ZoomingGuy2/RSFQ-test-board/README.md

# Digital RSFQ Test PCB

## Specs
- PCB designedi for I/O speeds up to 200 MHz
- 10 inputs, 20 outputs
- Compatible with CMOD A7-35T FPGA board
- 512KB SRAM
- 4MB Quad-SPI Flash
- 20,800 LUT
- 41,600 FF
- 225 KB BRAM
- 4.3W max power consumption
