ZoomingGuy2/RSFQ-test-board/test_board/production/bom.csv

Designator | Footprint | Quantity | Value | LCSC Part #
R1, R11, R13, R15, R17, R19, R21, R23, R25, R27, R29, R3, R31, R33, R35, R37, R39, R5, R7, R9 | R_0603 | 20 | 1.5kΩ | C22843
R10, R12, R14, R16, R18, R2, R20, R22, R24, R26, R28, R30, R32, R34, R36, R38, R4, R40, R41, R42, R43, R44, R45, R46, R47, R48, R49, R50, R6, R8 | R_0603 | 30 | 51Ω | C23197
RF1, RF10, RF11, RF12, RF13, RF14, RF15, RF16, RF17, RF18, RF19, RF2, RF20, RF21, RF22, RF23, RF24, RF25, RF26, RF27, RF28, RF29, RF3, RF30, RF4, RF5, RF6, RF7, RF8, RF9 | SMA-TH_BWSMA-KE-Z001 | 30 | BWSMA-KE-Z001 | C496549
U1, U10, U11, U12, U3, U5, U6, U7, U8, U9 | SC-70-5_L2.0-W1.3-P0.65-LS2.1-BR | 10 | TLV3601DCKR | C2974371
U2 | A7-35T | 1 | ~
U4 | SOT-223-3_L6.5-W3.4-P2.30-LS7.0-BR | 1 | AMS1117 | C6186
