ZoomingGuy2/RSFQ-test-board/test_board/test_board.kicad_pcb

## KiCad design test_board/test_board.kicad_pcb (2026-01-09)

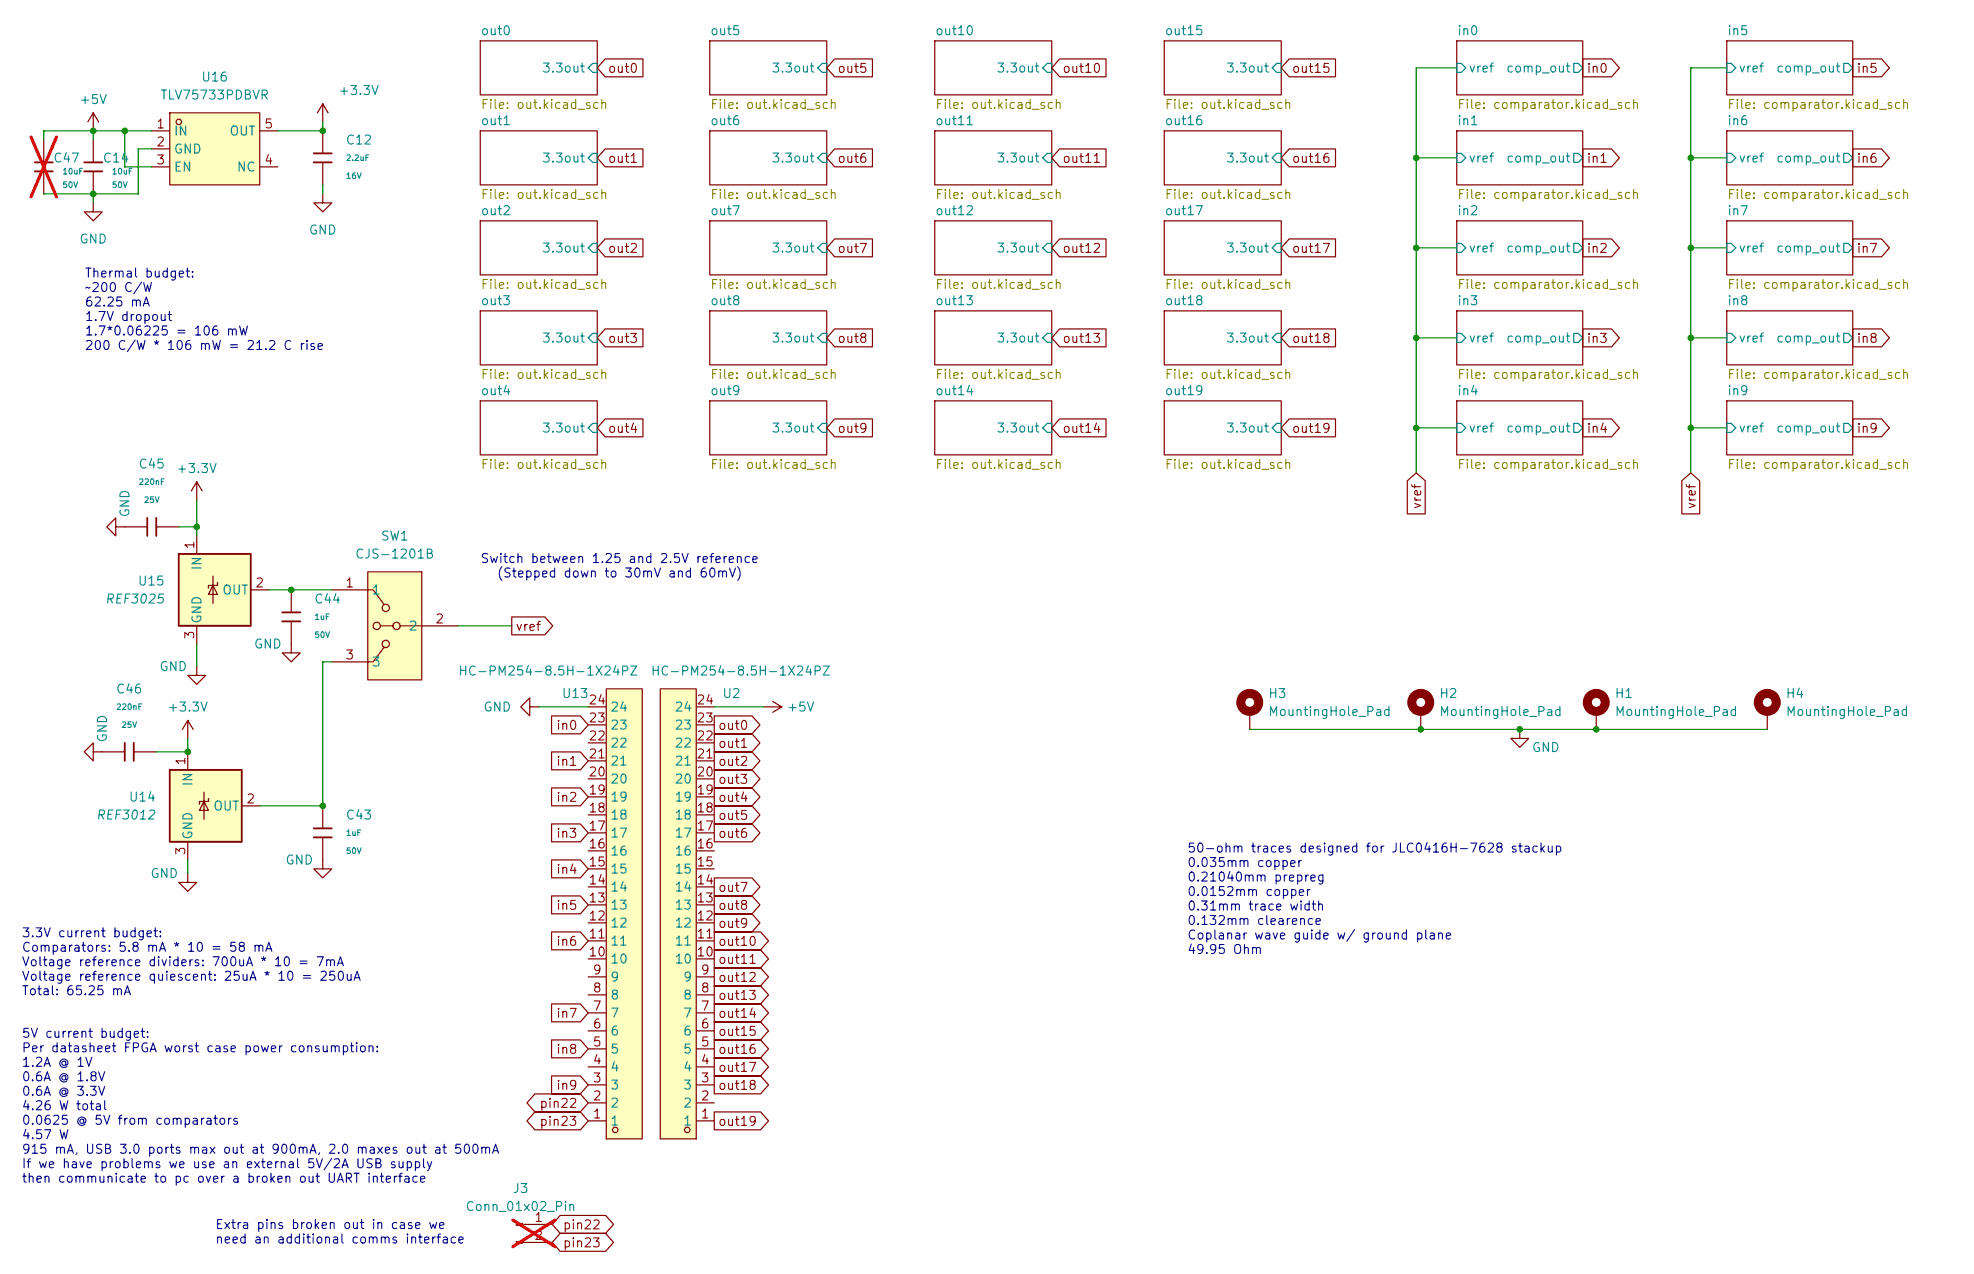
[picture p1: schematic test_board.kicad_sch]

Parts:
C12: 2.2uF; C_0603; Voltage Rated 16V; Tolerance ±10%; Part CL10A225KO8NNNC; LCSC C23630
C14: 10uF; C_0805; Voltage Rated 50V; Tolerance ±10%; Part GRM21BR61H106KE43L; LCSC C440198
C43, C44: 1uF; C_0603; Voltage Rated 50V; Tolerance ±10%; Part CL10A105KB8NNNC; LCSC C15849
C45, C46: 220nF; C_0603; Voltage Rated 25V; Tolerance ±10%; Part CL10B224KA8NNNC; LCSC C21120
C47: 10uF; C_0805; Voltage Rated 50V; Tolerance ±10%; Part GRM21BR61H106KE43L; LCSC C440198; not fitted
H1, H2, H3, H4: MountingHole_Pad; MountingHole_4.5mm_Pad
J3: Conn_01x02_Pin; PinHeader_1x02_P2.54mm_Vertical; not fitted
SW1: CJS-1201B; SW-SMD_CJS-1201B; LCSC Part C132858
U2, U13: HC-PM254-8.5H-1X24PZ; HDR-TH_24P-P2.54-V-F; LCSC Part C41376163
U14: REF3012; SOT-23
U15: REF3025; SOT-23
U16: TLV75733PDBVR; SOT-23-5_L2.9-W1.6-P0.95-LS2.8-BL; LCSC Part C485517

Connections:
+3.3V: C12.1, C45.2, C46.2, U14.1 (IN), U15.1 (IN), U16.5 (OUT); also elsewhere on the board
+5V: C14.1, C47.1, U2.24, U16.1 (IN), U16.3 (EN)
GND: C12.2, C14.2, C43.2, C44.2, C45.1, C46.1, C47.2, H1.1, H2.1, H3.1, H4.1, U13.24, U14.3 (GND), U15.3 (GND), U16.2 (GND); also elsewhere on the board
unnamed: C43.1, SW1.3, U14.2 (OUT)
unnamed: C44.1, SW1.1, U15.2 (OUT)
in0: U13.23; also elsewhere on the board
in1: U13.21; also elsewhere on the board
in2: U13.19; also elsewhere on the board
in3: U13.17; also elsewhere on the board
in4: U13.15; also elsewhere on the board
in5: U13.13; also elsewhere on the board
in6: U13.11; also elsewhere on the board
in7: U13.7; also elsewhere on the board
in8: U13.5; also elsewhere on the board
in9: U13.3; also elsewhere on the board
out0: U2.23; also elsewhere on the board
out1: U2.22; also elsewhere on the board
out2: U2.21; also elsewhere on the board
out3: U2.20; also elsewhere on the board
out4: U2.19; also elsewhere on the board
out5: U2.18; also elsewhere on the board
out6: U2.17; also elsewhere on the board
out7: U2.14; also elsewhere on the board
out8: U2.13; also elsewhere on the board
out9: U2.12; also elsewhere on the board
out10: U2.11; also elsewhere on the board
out11: U2.10; also elsewhere on the board
out12: U2.9; also elsewhere on the board
out13: U2.8; also elsewhere on the board
out14: U2.7; also elsewhere on the board
out15: U2.6; also elsewhere on the board
out16: U2.5; also elsewhere on the board
out17: U2.4; also elsewhere on the board
out18: U2.3; also elsewhere on the board
out19: U2.1; also elsewhere on the board
pin22: J3.1, U13.2
pin23: J3.2, U13.1
vref: SW1.2; also elsewhere on the board

Notes on the sheet:
Switch between 1.25 and 2.5V reference (Stepped down to 30mV and 60mV)
50-ohm traces designed for JLC0416H-7628 stackup 0.035mm copper 0.21040mm prepreg 0.0152mm copper 0.31mm trace width 0.132mm clearence Coplanar wave guide w/ ground plane 49.95 Ohm
Thermal budget: ~200 C/W 62.25 mA 1.7V dropout 1.7*0.06225 = 106 mW 200 C/W * 106 mW = 21.2 C rise
5V current budget: Per datasheet FPGA worst case power consumption: 1.2A @ 1V 0.6A @ 1.8V 0.6A @ 3.3V 4.26 W total 0.0625 @ 5V from comparators 4.57 W 915 mA, USB 3.0 ports max out at 900mA, 2.0 maxes out at 500mA If we have problems we use an external 5V/2A USB supply then communicate to pc over a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
3.3V current budget: Comparators: 5.8 mA * 10 = 58 mA Voltage reference dividers: 700uA * 10 = 7mA Voltage reference quiescent: 25uA * 10 = 250uA Total: 65.25 mA
Extra pins broken out in case we need an additional comms interface

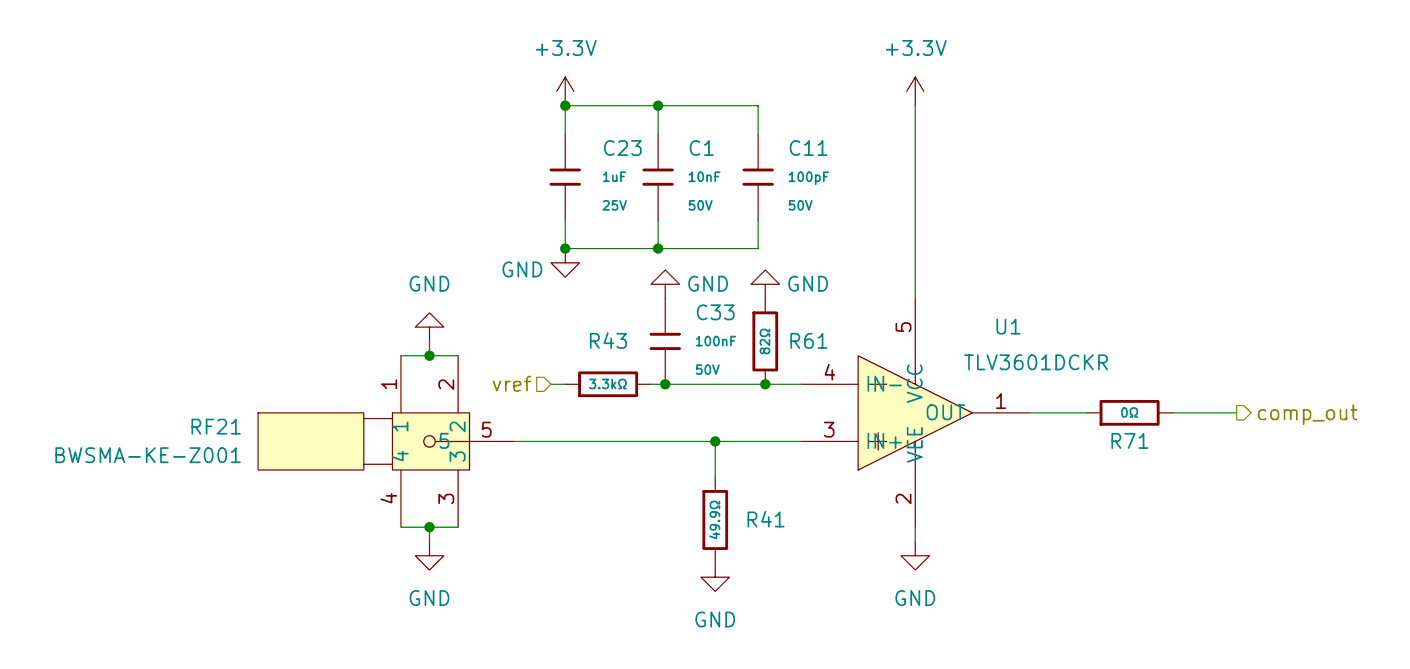
[picture p2: schematic comparator.kicad_sch]

Parts:
C1: 10nF; C_0402; Voltage Rated 50V; Tolerance ±10%; Part CL05B103KB5NNNC; LCSC C15195
C11: 100pF; C_0402; Voltage Rated 50V; Tolerance ±5%; Part 0402CG101J500NT; LCSC C1546
C23: 1uF; C_0402; Voltage Rated 25V; Tolerance ±10%; Part CL05A105KA5NQNC; LCSC C52923
C33: 100nF; C_0603; Voltage Rated 50V; Tolerance ±10%; Part CC0603KRX7R9BB104; LCSC C14663
R41: 49.9Ω; R_0402; Overload Voltage (Max) 50V; Tolerance ±1%; Part 0402WGF499JTCE; LCSC C25120
R43: 3.3kΩ; R_0603; Overload Voltage (Max) 75V; Tolerance ±1%; Part 0603WAF3301T5E; LCSC C22978
R61: 82Ω; R_0603; Overload Voltage (Max) 75V; Tolerance ±1%; Part 0603WAF820JT5E; LCSC C23255
R71: 0Ω; R_0402; Overload Voltage (Max) 50V; Tolerance ±1%; Part 0402WGF0000TCE; LCSC C17168
RF21: BWSMA-KE-Z001; SMA-TH_BWSMA-KE-Z001; LCSC Part C496549
U1: TLV3601DCKR; SC-70-5_L2.0-W1.3-P0.65-LS2.1-BR; LCSC Part C2974371

Connections:
+3.3V: C1.1, C11.1, C23.1, U1.5 (VCC); also elsewhere on the board
GND: C1.2, C11.2, C23.2, C33.1, R41.2, R61.1, RF21.1, RF21.2, RF21.3, RF21.4, U1.2 (VEE); also elsewhere on the board
unnamed: R41.1, RF21.5, U1.3 (IN+)
unnamed: C33.2, R43.2, R61.2, U1.4 (IN-)
unnamed: R71.1, U1.1 (OUT)
in0: R71.2; also elsewhere on the board
vref: R43.1; also elsewhere on the board

Parts of its further copies:
C2, C3, C4, C5, C6, C7, C8, C9, C10: 10nF; C_0402; Voltage Rated 50V; Tolerance ±10%; Part CL05B103KB5NNNC; LCSC C15195
C13, C15, C16, C17, C18, C19, C20, C21, C22: 100pF; C_0402; Voltage Rated 50V; Tolerance ±5%; Part 0402CG101J500NT; LCSC C1546
C24, C25, C26, C27, C28, C29, C30, C31, C32: 1uF; C_0402; Voltage Rated 25V; Tolerance ±10%; Part CL05A105KA5NQNC; LCSC C52923
C34, C35, C36, C37, C38, C39, C40, C41, C42: 100nF; C_0603; Voltage Rated 50V; Tolerance ±10%; Part CC0603KRX7R9BB104; LCSC C14663
R42, R45, R47, R49, R51, R53, R55, R57, R59: 49.9Ω; R_0402; Overload Voltage (Max) 50V; Tolerance ±1%; Part 0402WGF499JTCE; LCSC C25120
R44, R46, R48, R50, R52, R54, R56, R58, R60: 3.3kΩ; R_0603; Overload Voltage (Max) 75V; Tolerance ±1%; Part 0603WAF3301T5E; LCSC C22978
R62, R63, R64, R65, R66, R67, R68, R69, R70: 82Ω; R_0603; Overload Voltage (Max) 75V; Tolerance ±1%; Part 0603WAF820JT5E; LCSC C23255
R72, R73, R74, R75, R76, R77, R78, R79, R80: 0Ω; R_0402; Overload Voltage (Max) 50V; Tolerance ±1%; Part 0402WGF0000TCE; LCSC C17168
RF22, RF23, RF24, RF25, RF26, RF27, RF28, RF29, RF30: BWSMA-KE-Z001; SMA-TH_BWSMA-KE-Z001; LCSC Part C496549
U3, U5, U6, U7, U8, U9, U10, U11, U12: TLV3601DCKR; SC-70-5_L2.0-W1.3-P0.65-LS2.1-BR; LCSC Part C2974371

Connections of its further copies:
+3.3V: C2.1, C3.1, C4.1, C5.1, C6.1, C7.1, C8.1, C9.1, C10.1, C13.1, C15.1, C16.1, C17.1, C18.1, C19.1, C20.1, C21.1, C22.1, C24.1, C25.1, C26.1, C27.1, C28.1, C29.1, C30.1, C31.1, C32.1, U3.5 (VCC), U5.5 (VCC), U6.5 (VCC), U7.5 (VCC), U8.5 (VCC), U9.5 (VCC), U10.5 (VCC), U11.5 (VCC), U12.5 (VCC); also elsewhere on the board
GND: C2.2, C3.2, C4.2, C5.2, C6.2, C7.2, C8.2, C9.2, C10.2, C13.2, C15.2, C16.2, C17.2, C18.2, C19.2, C20.2, C21.2, C22.2, C24.2, C25.2, C26.2, C27.2, C28.2, C29.2, C30.2, C31.2, C32.2, C34.1, C35.1, C36.1, C37.1, C38.1, C39.1, C40.1, C41.1, C42.1, R42.2, R45.2, R47.2, R49.2, R51.2, R53.2, R55.2, R57.2, R59.2, R62.1, R63.1, R64.1, R65.1, R66.1, R67.1, R68.1, R69.1, R70.1, RF22.1, RF22.2, RF22.3, RF22.4, RF23.1, RF23.2, RF23.3, RF23.4, RF24.1, RF24.2, RF24.3, RF24.4, RF25.1, RF25.2, RF25.3, RF25.4, RF26.1, RF26.2, RF26.3, RF26.4, RF27.1, RF27.2, RF27.3, RF27.4, RF28.1, RF28.2, RF28.3, RF28.4, RF29.1, RF29.2, RF29.3, RF29.4, RF30.1, RF30.2, RF30.3, RF30.4, U3.2 (VEE), U5.2 (VEE), U6.2 (VEE), U7.2 (VEE), U8.2 (VEE), U9.2 (VEE), U10.2 (VEE), U11.2 (VEE), U12.2 (VEE); also elsewhere on the board
unnamed: R42.1, RF22.5, U3.3 (IN+)
unnamed: C34.2, R44.2, R62.2, U3.4 (IN-)
unnamed: R72.1, U3.1 (OUT)
unnamed: R45.1, RF23.5, U5.3 (IN+)
unnamed: C35.2, R46.2, R63.2, U5.4 (IN-)
unnamed: R73.1, U5.1 (OUT)
unnamed: R47.1, RF24.5, U6.3 (IN+)
unnamed: C36.2, R48.2, R64.2, U6.4 (IN-)
unnamed: R74.1, U6.1 (OUT)
unnamed: R49.1, RF25.5, U7.3 (IN+)
unnamed: C37.2, R50.2, R65.2, U7.4 (IN-)
unnamed: R75.1, U7.1 (OUT)
unnamed: R51.1, RF26.5, U8.3 (IN+)
unnamed: C38.2, R52.2, R66.2, U8.4 (IN-)
unnamed: R76.1, U8.1 (OUT)
unnamed: R53.1, RF27.5, U9.3 (IN+)
unnamed: C39.2, R54.2, R67.2, U9.4 (IN-)
unnamed: R77.1, U9.1 (OUT)
unnamed: R55.1, RF28.5, U10.3 (IN+)
unnamed: C40.2, R56.2, R68.2, U10.4 (IN-)
unnamed: R78.1, U10.1 (OUT)
unnamed: R57.1, RF29.5, U11.3 (IN+)
unnamed: C41.2, R58.2, R69.2, U11.4 (IN-)
unnamed: R79.1, U11.1 (OUT)
unnamed: R59.1, RF30.5, U12.3 (IN+)
unnamed: C42.2, R60.2, R70.2, U12.4 (IN-)
unnamed: R80.1, U12.1 (OUT)
in1: R72.2; also elsewhere on the board
in2: R73.2; also elsewhere on the board
in3: R74.2; also elsewhere on the board
in4: R75.2; also elsewhere on the board
in5: R76.2; also elsewhere on the board
in6: R77.2; also elsewhere on the board
in7: R78.2; also elsewhere on the board
in8: R79.2; also elsewhere on the board
in9: R80.2; also elsewhere on the board
vref: R44.1, R46.1, R48.1, R50.1, R52.1, R54.1, R56.1, R58.1, R60.1; also elsewhere on the board

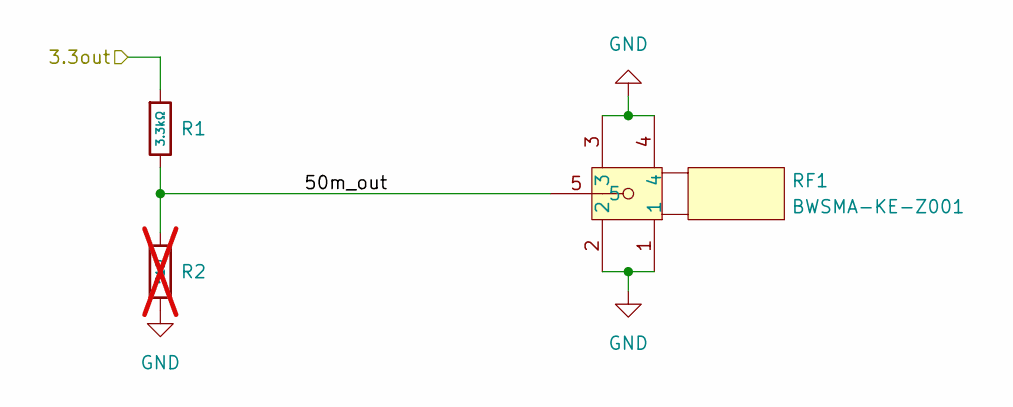
[picture p3: schematic out.kicad_sch]

Parts:
R1: 3.3kΩ; R_0402; Overload Voltage (Max) 50V; Tolerance ±1%; Part 0402WGF3301TCE; LCSC C25890
R2: 51Ω; R_0402; Overload Voltage (Max) 50V; Tolerance ±1%; Part 0402WGF510JTCE; LCSC C25125; not fitted
RF1: BWSMA-KE-Z001; SMA-TH_BWSMA-KE-Z001; LCSC Part C496549

Connections:
/out0/50m_out: R1.2, R2.1, RF1.5
GND: R2.2, RF1.1, RF1.2, RF1.3, RF1.4; also elsewhere on the board
out0: R1.1; also elsewhere on the board

Parts of its further copies:
R3, R5, R7, R9, R11, R13, R15, R17, R19, R21, R23, R25, R27, R29, R31, R33, R35, R37, R39: 3.3kΩ; R_0402; Overload Voltage (Max) 50V; Tolerance ±1%; Part 0402WGF3301TCE; LCSC C25890
R4, R6, R8, R10, R12, R14, R16, R18, R20, R22, R24, R26, R28, R30, R32, R34, R36, R38, R40: 51Ω; R_0402; Overload Voltage (Max) 50V; Tolerance ±1%; Part 0402WGF510JTCE; LCSC C25125; not fitted
RF2, RF3, RF4, RF5, RF6, RF7, RF8, RF9, RF10, RF11, RF12, RF13, RF14, RF15, RF16, RF17, RF18, RF19, RF20: BWSMA-KE-Z001; SMA-TH_BWSMA-KE-Z001; LCSC Part C496549

Connections of its further copies:
/out1/50m_out: R3.2, R4.1, RF2.5
/out2/50m_out: R5.2, R6.1, RF3.5
/out3/50m_out: R7.2, R8.1, RF4.5
/out4/50m_out: R9.2, R10.1, RF5.5
/out5/50m_out: R11.2, R12.1, RF6.5
/out6/50m_out: R13.2, R14.1, RF7.5
/out7/50m_out: R15.2, R16.1, RF8.5
/out8/50m_out: R17.2, R18.1, RF9.5
/out9/50m_out: R19.2, R20.1, RF10.5
/out10/50m_out: R21.2, R22.1, RF11.5
/out11/50m_out: R23.2, R24.1, RF12.5
/out12/50m_out: R25.2, R26.1, RF13.5
/out13/50m_out: R27.2, R28.1, RF14.5
/out14/50m_out: R29.2, R30.1, RF15.5
/out15/50m_out: R31.2, R32.1, RF16.5
/out16/50m_out: R33.2, R34.1, RF17.5
/out17/50m_out: R35.2, R36.1, RF18.5
/out18/50m_out: R37.2, R38.1, RF19.5
/out19/50m_out: R39.2, R40.1, RF20.5
GND: R4.2, R6.2, R8.2, R10.2, R12.2, R14.2, R16.2, R18.2, R20.2, R22.2, R24.2, R26.2, R28.2, R30.2, R32.2, R34.2, R36.2, R38.2, R40.2, RF2.1, RF2.2, RF2.3, RF2.4, RF3.1, RF3.2, RF3.3, RF3.4, RF4.1, RF4.2, RF4.3, RF4.4, RF5.1, RF5.2, RF5.3, RF5.4, RF6.1, RF6.2, RF6.3, RF6.4, RF7.1, RF7.2, RF7.3, RF7.4, RF8.1, RF8.2, RF8.3, RF8.4, RF9.1, RF9.2, RF9.3, RF9.4, RF10.1, RF10.2, RF10.3, RF10.4, RF11.1, RF11.2, RF11.3, RF11.4, RF12.1, RF12.2, RF12.3, RF12.4, RF13.1, RF13.2, RF13.3, RF13.4, RF14.1, RF14.2, RF14.3, RF14.4, RF15.1, RF15.2, RF15.3, RF15.4, RF16.1, RF16.2, RF16.3, RF16.4, RF17.1, RF17.2, RF17.3, RF17.4, RF18.1, RF18.2, RF18.3, RF18.4, RF19.1, RF19.2, RF19.3, RF19.4, RF20.1, RF20.2, RF20.3, RF20.4; also elsewhere on the board
out1: R3.1; also elsewhere on the board
out2: R5.1; also elsewhere on the board
out3: R7.1; also elsewhere on the board
out4: R9.1; also elsewhere on the board
out5: R11.1; also elsewhere on the board
out6: R13.1; also elsewhere on the board
out7: R15.1; also elsewhere on the board
out8: R17.1; also elsewhere on the board
out9: R19.1; also elsewhere on the board
out10: R21.1; also elsewhere on the board
out11: R23.1; also elsewhere on the board
out12: R25.1; also elsewhere on the board
out13: R27.1; also elsewhere on the board
out14: R29.1; also elsewhere on the board
out15: R31.1; also elsewhere on the board
out16: R33.1; also elsewhere on the board
out17: R35.1; also elsewhere on the board
out18: R37.1; also elsewhere on the board
out19: R39.1; also elsewhere on the board

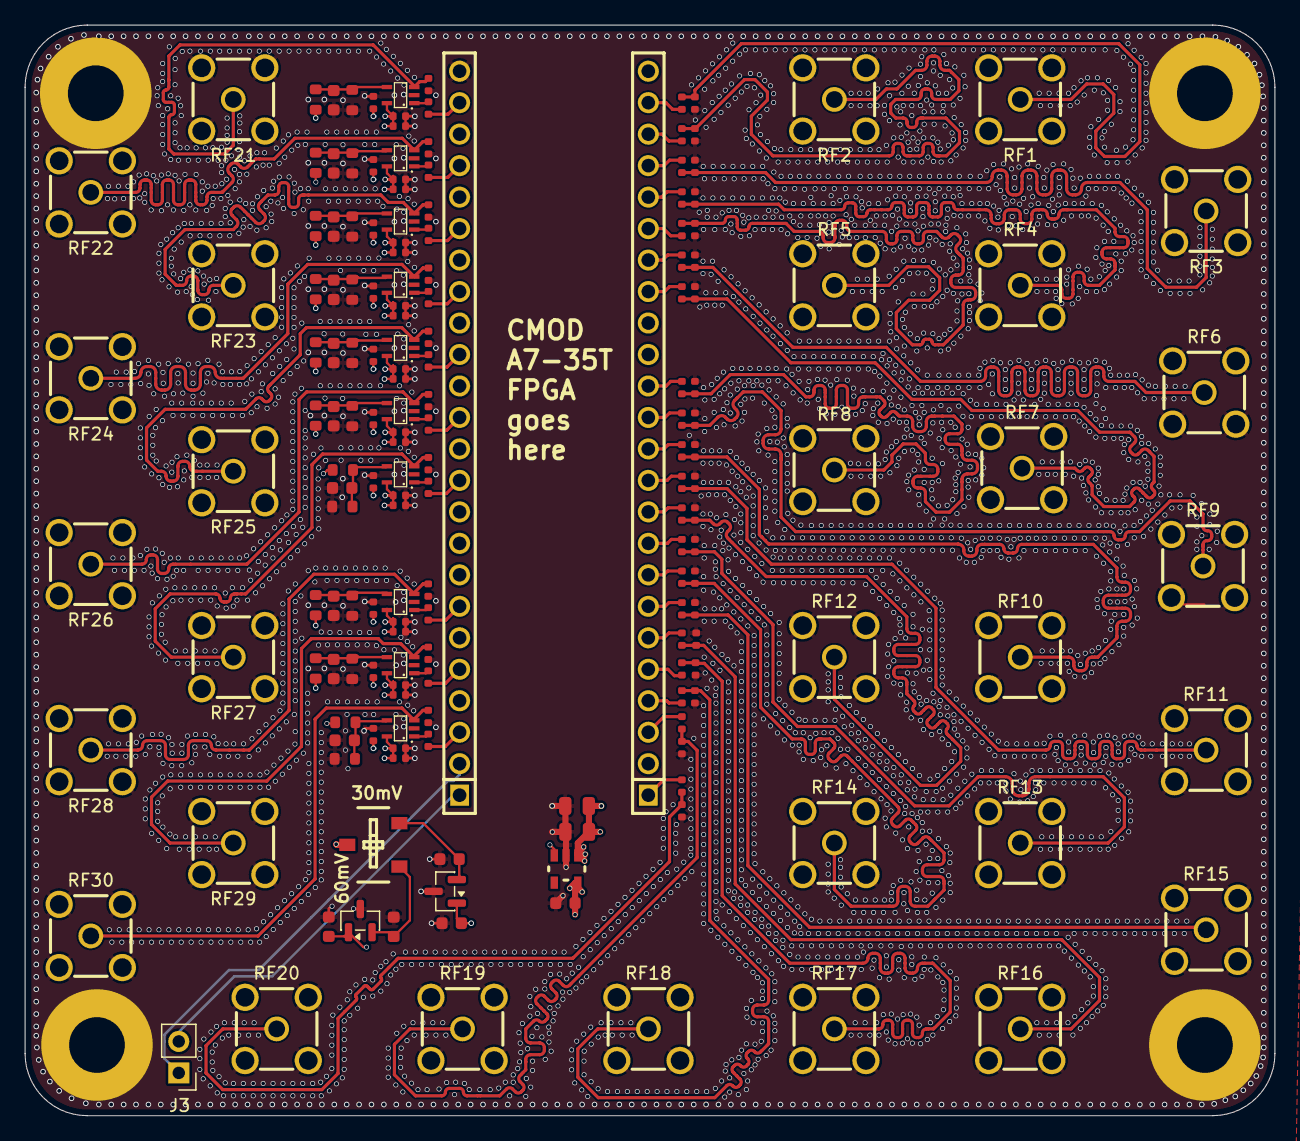
[picture p4: board test_board.kicad_pcb from above]

Board: 4 copper layers, 100.9 x 88.0 mm, 178 parts (0 on the bottom side), 88 nets.
