ZoomingGuy2/RSFQ-test-board/(commit log)

2025-12-19 added board
    [bom.csv, comparator.kicad_sch, designators.csv, divider.kicad_sch, out.kicad_sch, positions.csv, rf_connectors.kicad_sch, test_board.kicad_pcb]
2025-12-19 removed old schematics
    [divider.kicad_sch, rf_connectors.kicad_sch]
2025-12-19 added uart connector
    [test_board.kicad_pcb, test_board.kicad_sch]
2025-12-23 added decoupling caps to regulator and changed comparator termination resistor to 49.9 ohm
    [comparator.kicad_sch, test_board.kicad_pcb, test_board.kicad_sch]
2025-12-25 spaced out SMA connectors
    [test_board.kicad_pcb, test_board.kicad_sch]
2025-12-25 finished routing just need to add fencing vias
    [test_board.kicad_pcb, test_board.kicad_sch]
2025-12-27 finished board
    [test_board.kicad_sch]
2026-01-09 added pcb
    [test_board.kicad_pcb, test_board.kicad_sch]
2026-01-09 added 0 ohm resistor to comparator output
    [test_board.kicad_pcb]
2026-01-09 added 0 ohm resistor
    [comparator.kicad_sch]
2026-01-09 fixed output
    [out.kicad_sch]
2026-01-09 changed rotation
    [test_board.kicad_pcb, test_board.kicad_sch]
